niftypsycho/PhobGCCv2-HW_Din/graphics/Din_talking_spring.png

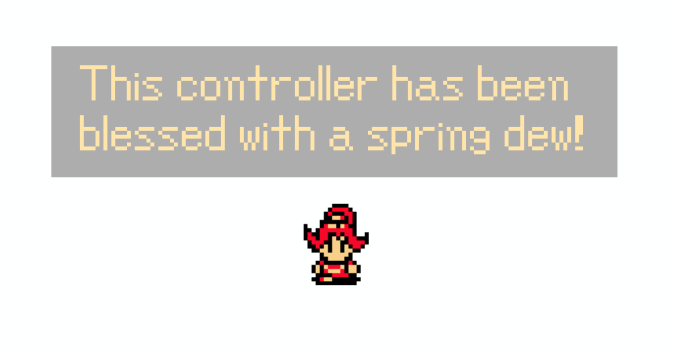
graphics/Din_talking_spring.png
