niftypsycho/PhobGCCv2-HW_Din/3D Models/DH1H1_Magnet_Holder_JLCPCB.STL

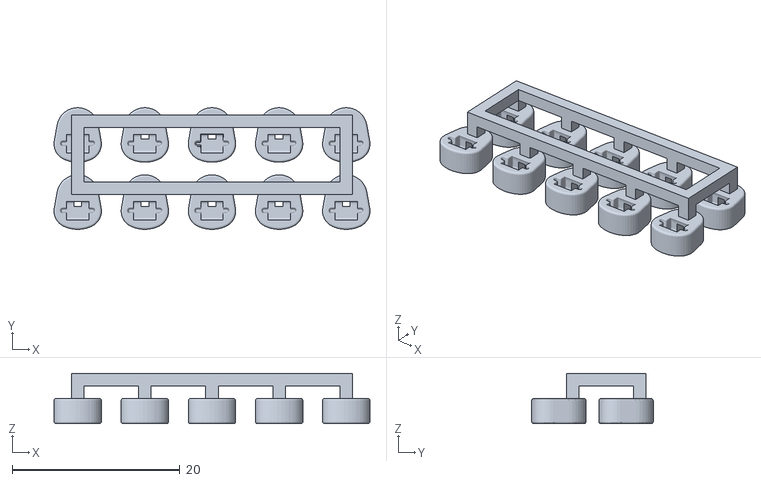
[picture p2: CAD file, 2023-04-25]
3D Models/DH1H1_Magnet_Holder_JLCPCB.STL
37.7 x 14.5 x 6.00
