niftypsycho/PhobGCCv2-HW_Din/(list of files, cad)

Other CAD files:
3D Models/MagnetHolder_underslung_DH1H1.scad
