niftypsycho/PhobGCCv2-HW_Din/PCB/KiCAD/assembly/PhobGCC_2_0_0_proto_1.pdf

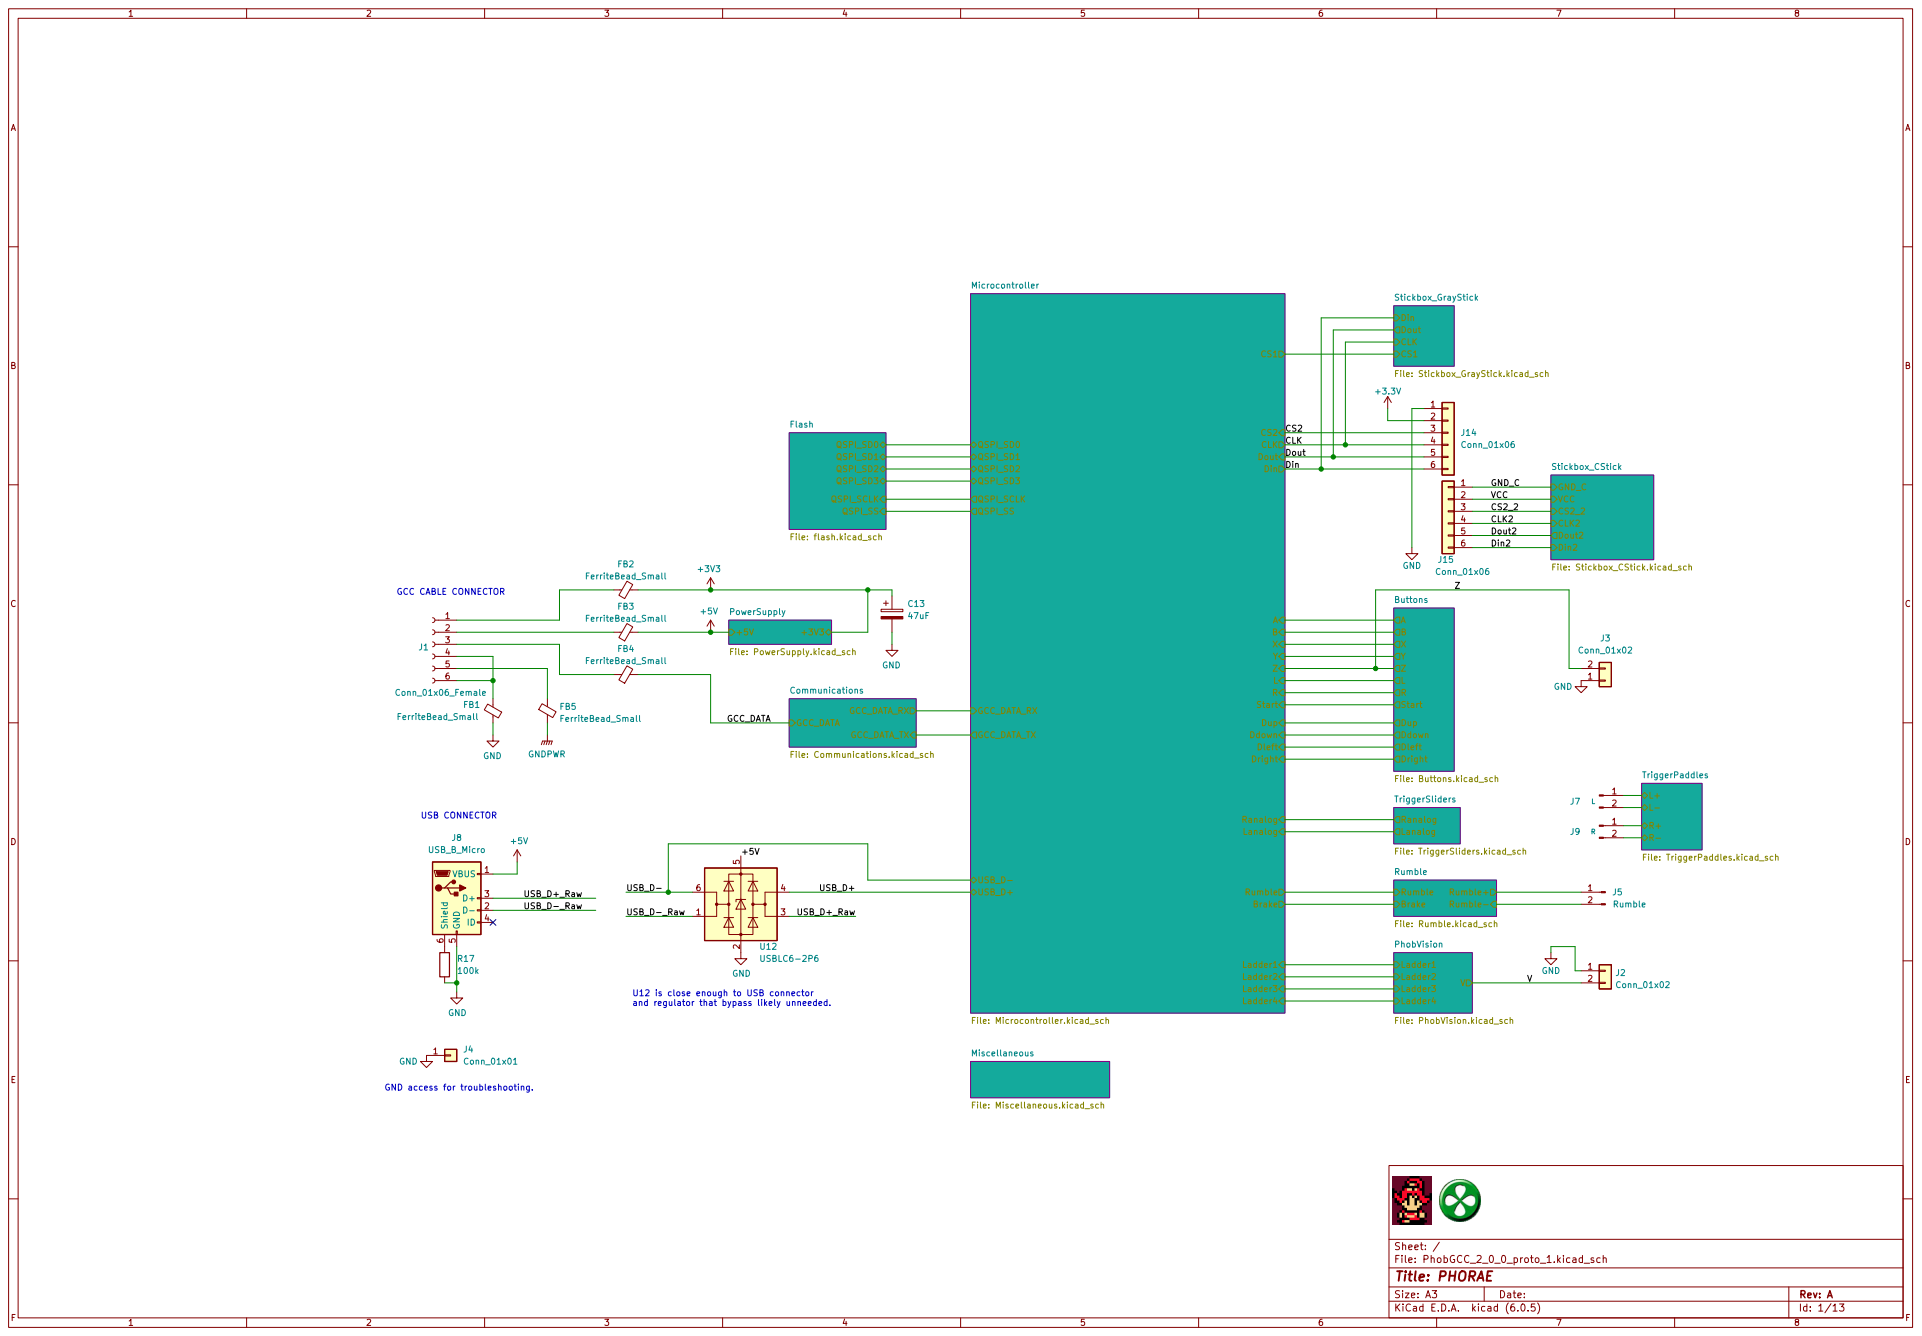
[picture p3: page 1]

Stickbox_CStick File: Stickbox_CStick.kicad_sch Dout CLK CS1 Din Stickbox_GrayStick

CS2_2 U12 is close enough to USB connector

and regulator that bypass likely unneeded. USB CONNECTOR GND access for troubleshooting.

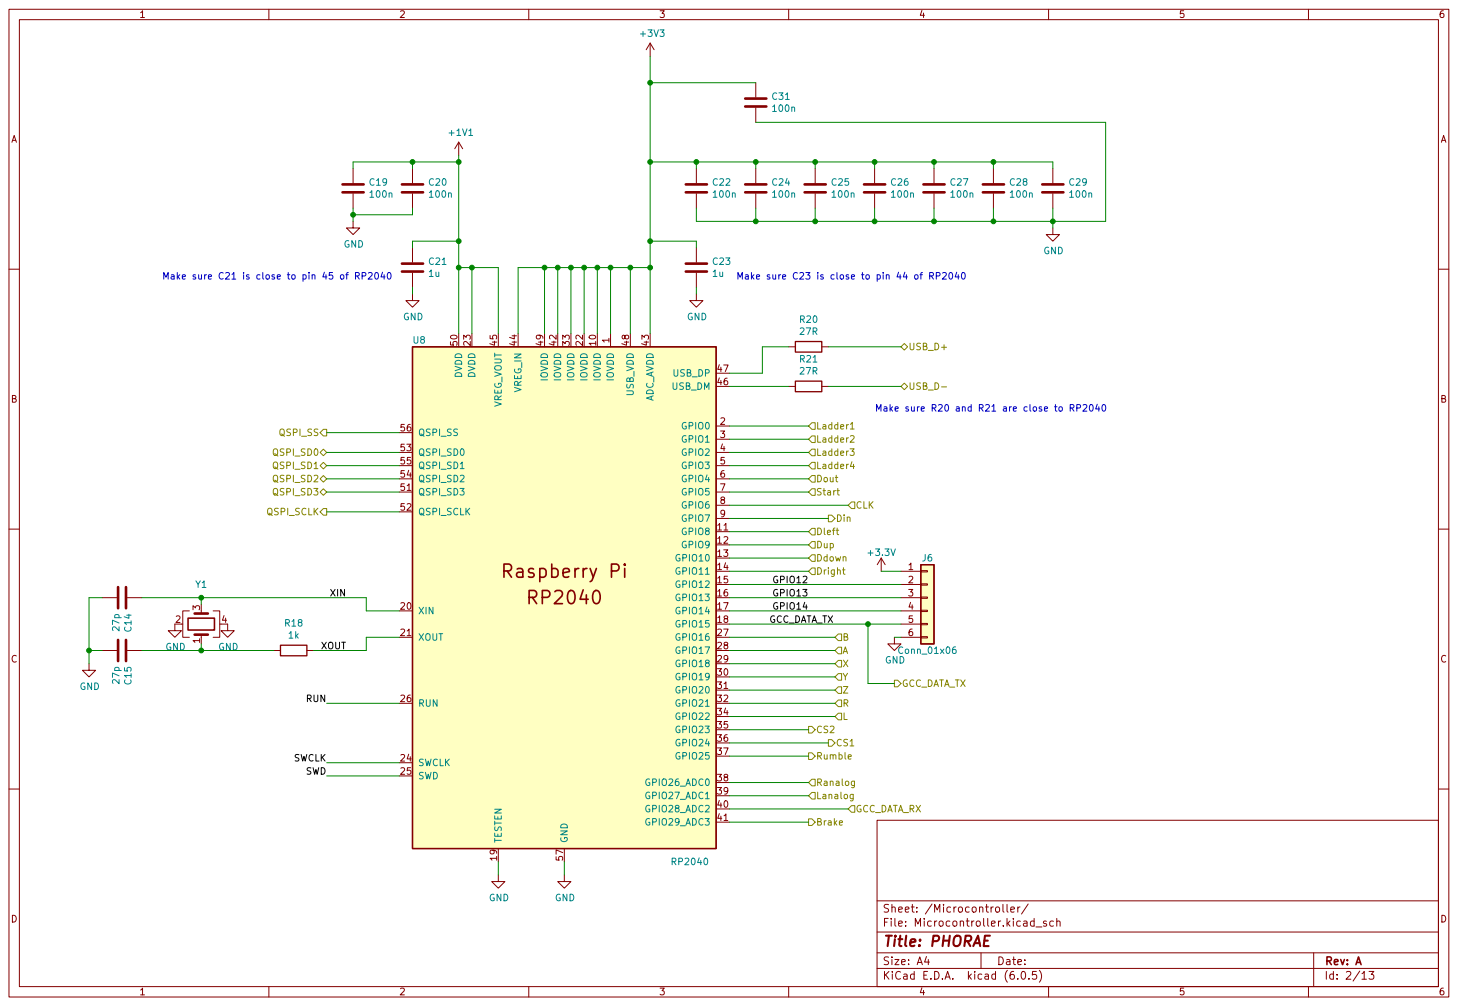
[picture p4: page 2]

1 IOVDD 10 GPIO8 11 GPIO9 12 GPIO10 13 GPIO11 14 GPIO12 15 GPIO13 16 GPIO14 17 GPIO15 18 TESTEN 19 GPIO0 2 XIN 20 XOUT 21 IOVDD 22 DVDD 23 SWCLK 24 SWD 25 RUN 26 GPIO16 27 GPIO17 28 GPIO18 29 GPIO1 3 GPIO19 30 GPIO20 31 GPIO21 32 IOVDD 33 GPIO22 34 GPIO23 35 GPIO24 36 GPIO25 37 GPIO26_ADC0 38 GPIO27_ADC1 39 GPIO2 4 GPIO28_ADC2 40 GPIO29_ADC3 41 IOVDD 42 ADC_AVDD 43 VREG_IN 44 VREG_VOUT 45 USB_DM 46 USB_DP 47 USB_VDD 48 IOVDD 49 GPIO3 5 DVDD 50 QSPI_SD3 51 QSPI_SCLK 52 QSPI_SD0 53 QSPI_SD2 54 QSPI_SD1 55 QSPI_SS 56 GND 57 GPIO4 6 GPIO5 7 GPIO6 8 GPIO7 9 U8 RP2040 StartDin Dright Ddown Dup Dout Ranalog USB_D+

File: Microcontroller.kicad_sch Sheet: /Microcontroller/
Id: 2/13 Title: PHORAE

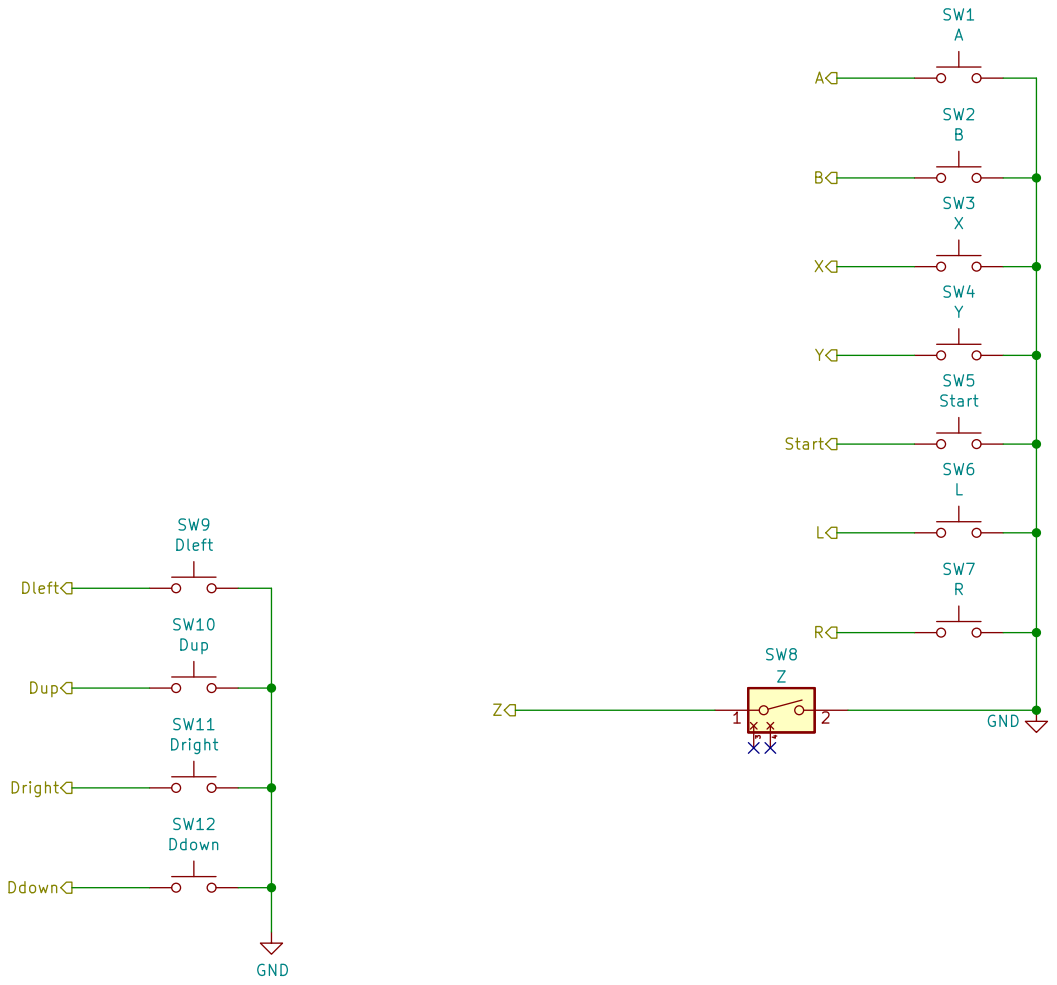
[picture p5: page 3]

File: Buttons.kicad_sch Sheet: /Buttons/
Id: 3/13 Title: PHORAE

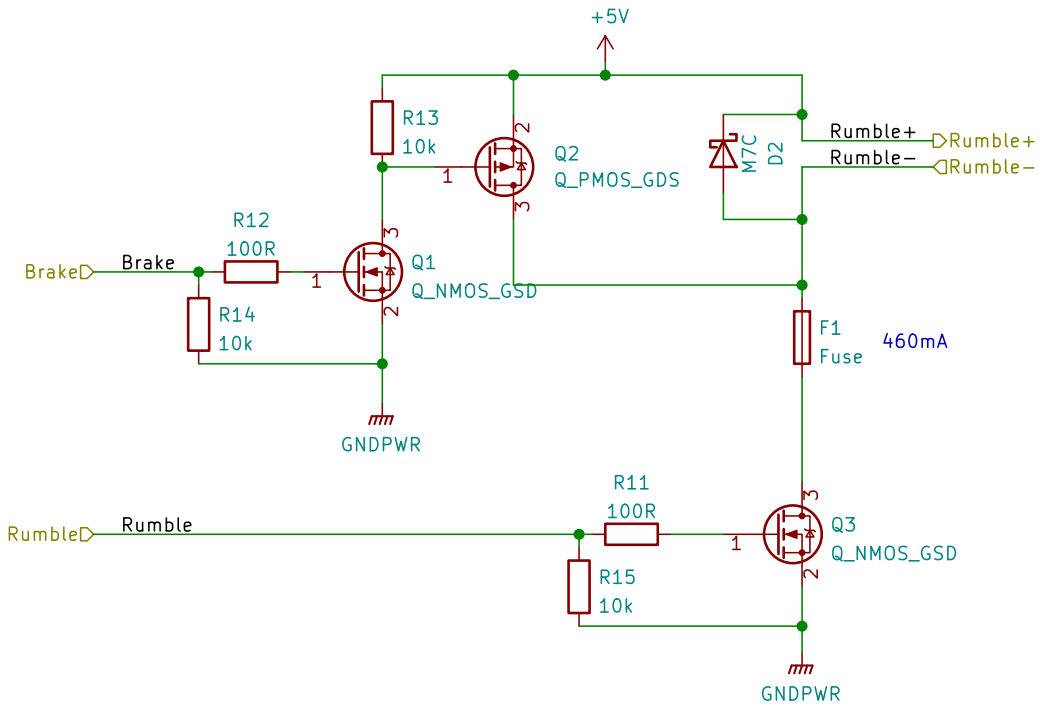
[picture p6: page 4]

File: Rumble.kicad_sch Sheet: /Rumble/ R11

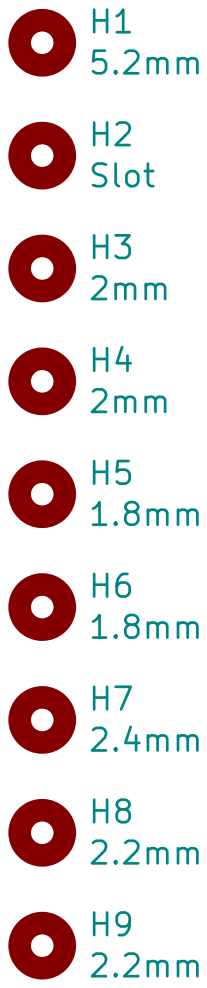
[picture p7: page 5]

File: Miscellaneous.kicad_sch Sheet: /Miscellaneous/
Id: 5/13 Title: PHORAE

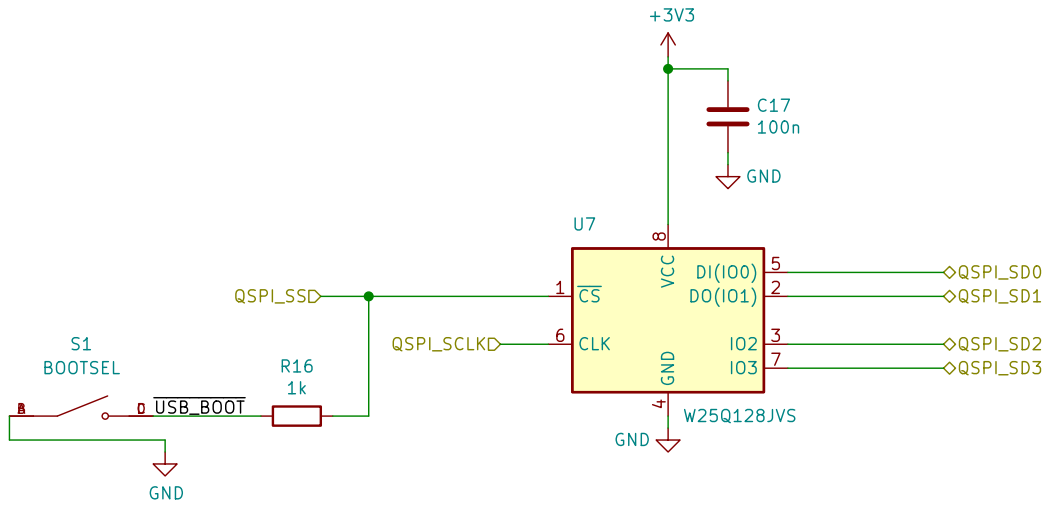
[picture p8: page 6]

File: flash.kicad_sch Sheet: /Flash/
Id: 6/13 Title: PHORAE

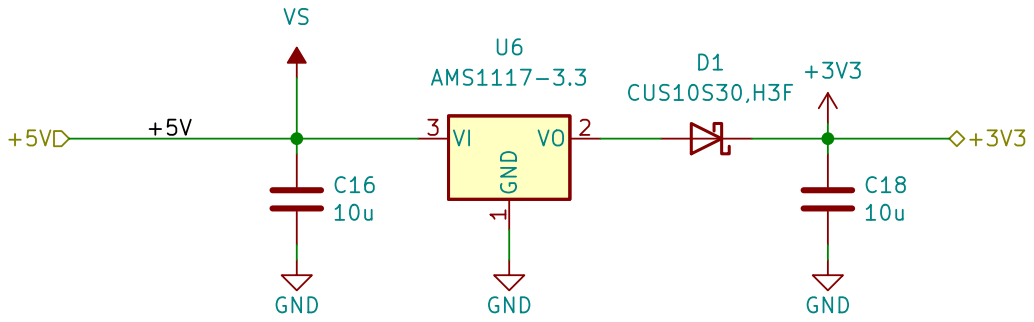
[picture p9: page 7]

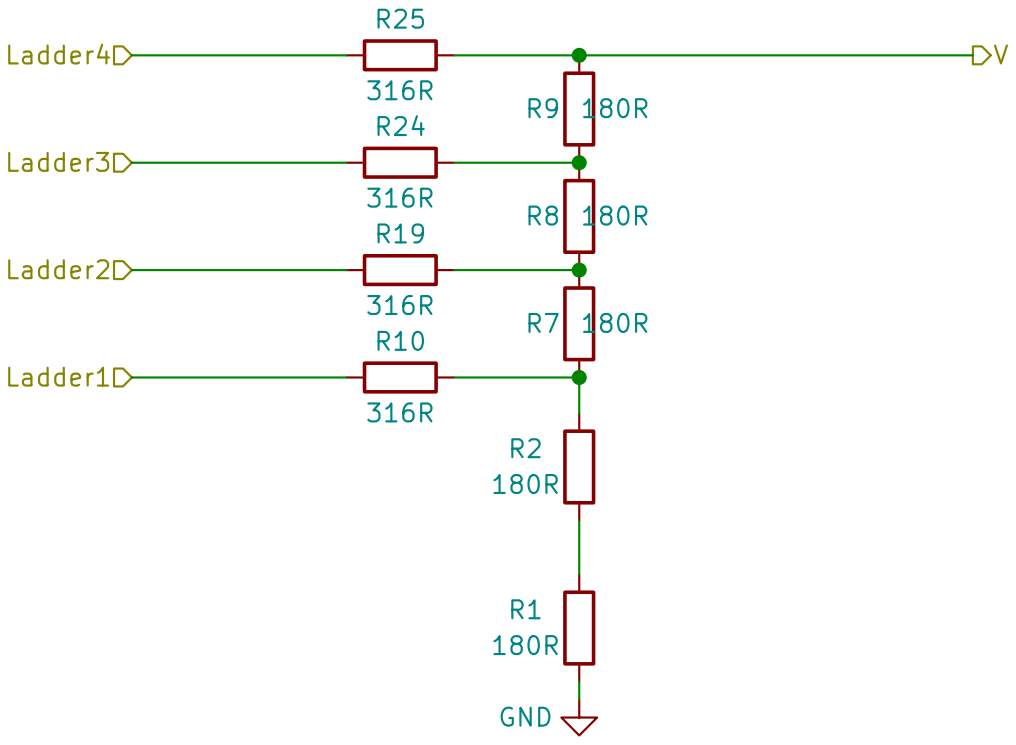
[picture p10: page 8]

File: PhobVision.kicad_sch Sheet: /PhobVision/ GND

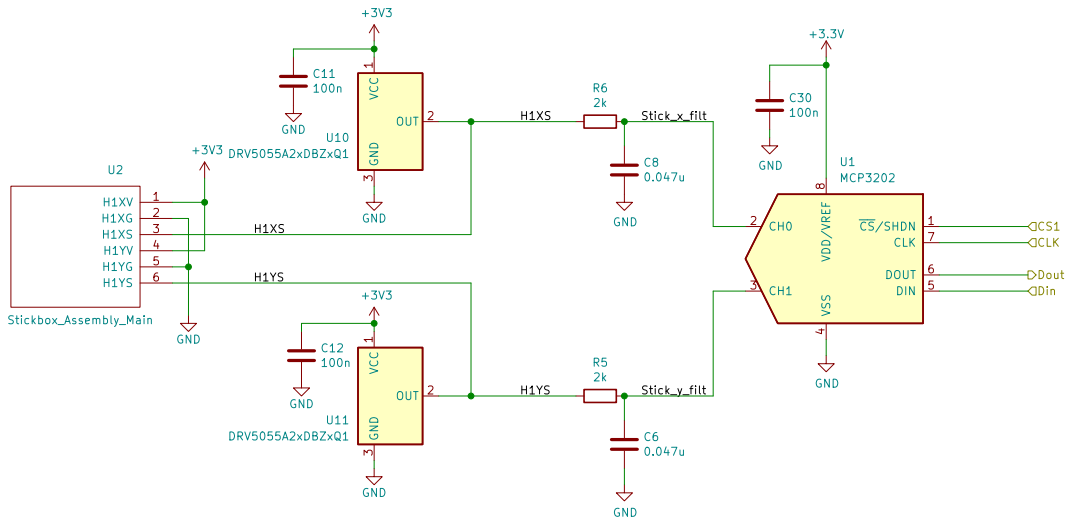
[picture p11: page 9]

4 DIN 5 DOUT 6 CLK 7 VDD/VREF

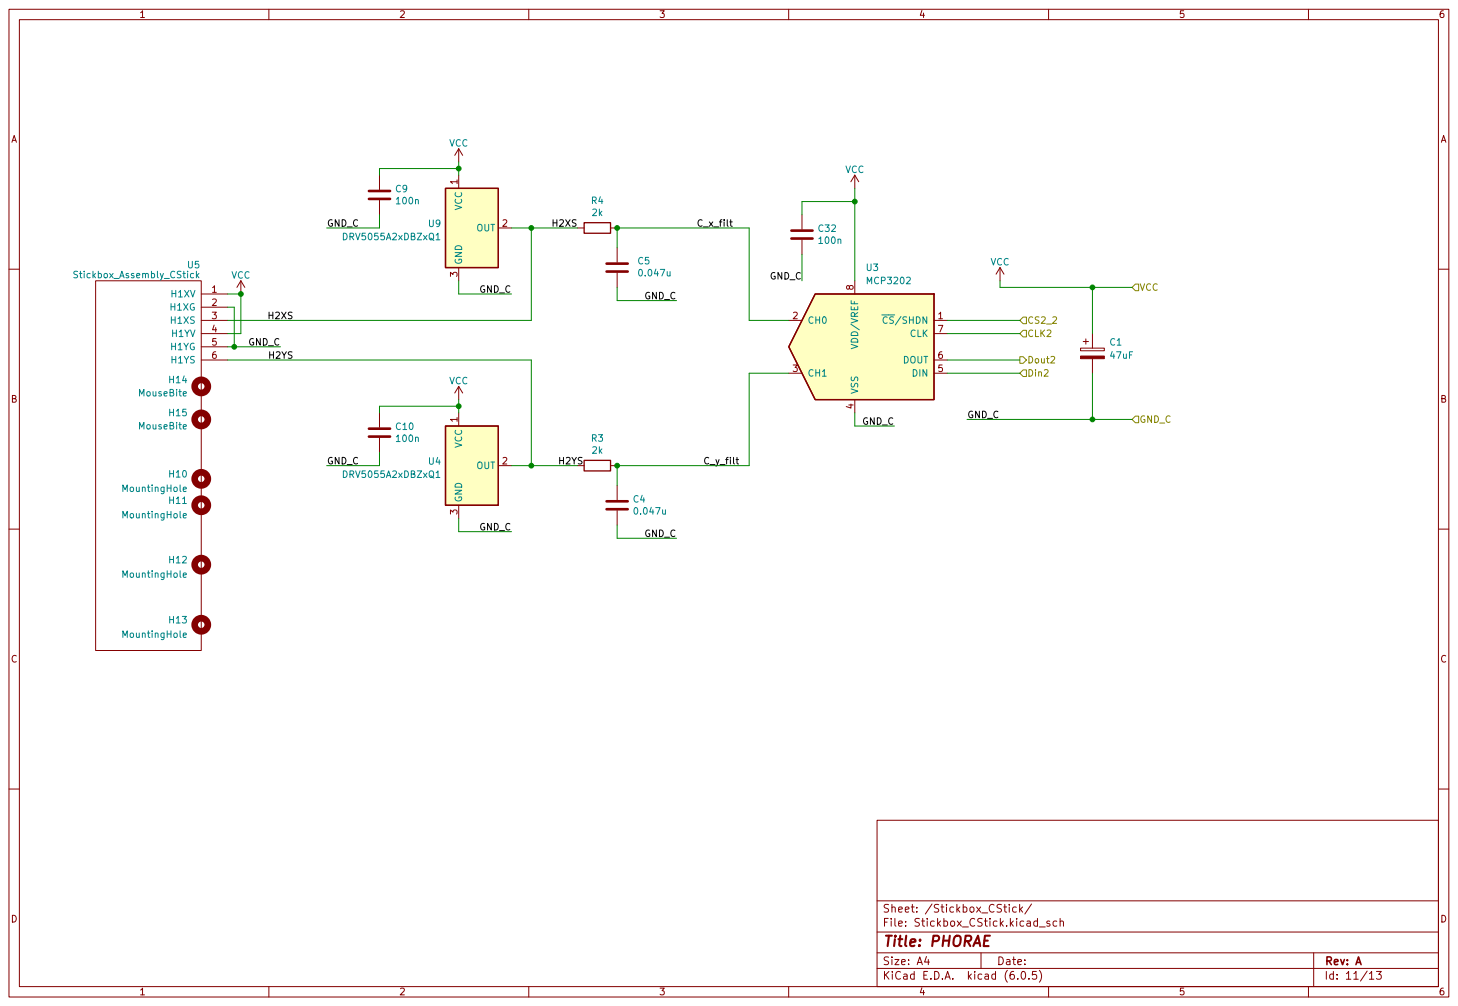
[picture p12: page 10]

4 DIN 5 DOUT 6 CLK 7 VDD/VREF

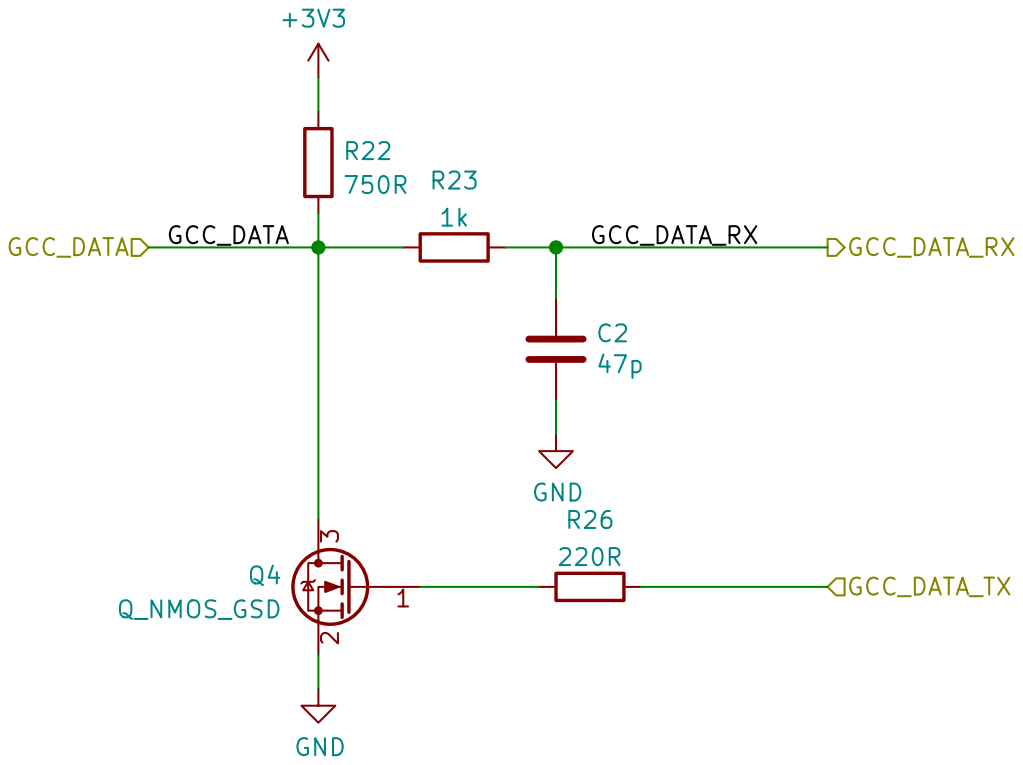
[picture p13: page 11]

File: Communications.kicad_sch Sheet: /Communications/ 1

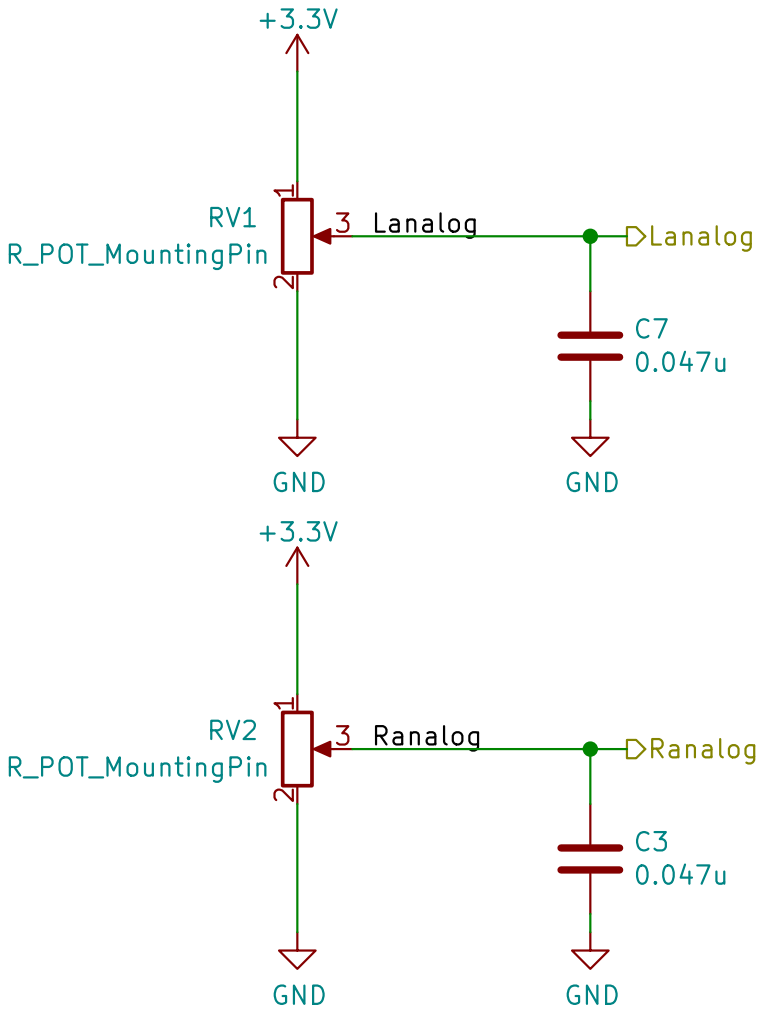
[picture p14: page 12]

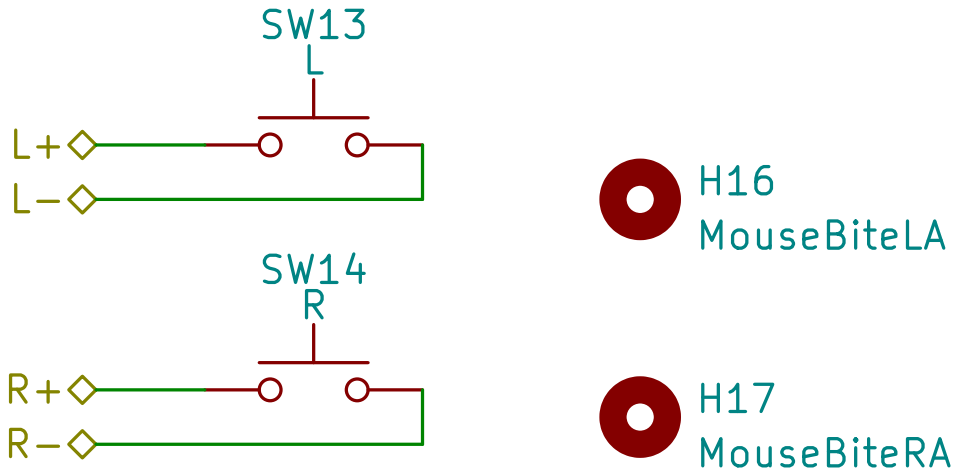
[picture p15: page 13]
