niftypsycho/PhobGCCv2-HW_Din/PCB/KiCAD/Buttons.kicad_sch

## KiCad design PCB/KiCAD/Buttons.kicad_sch (2023-04-25)

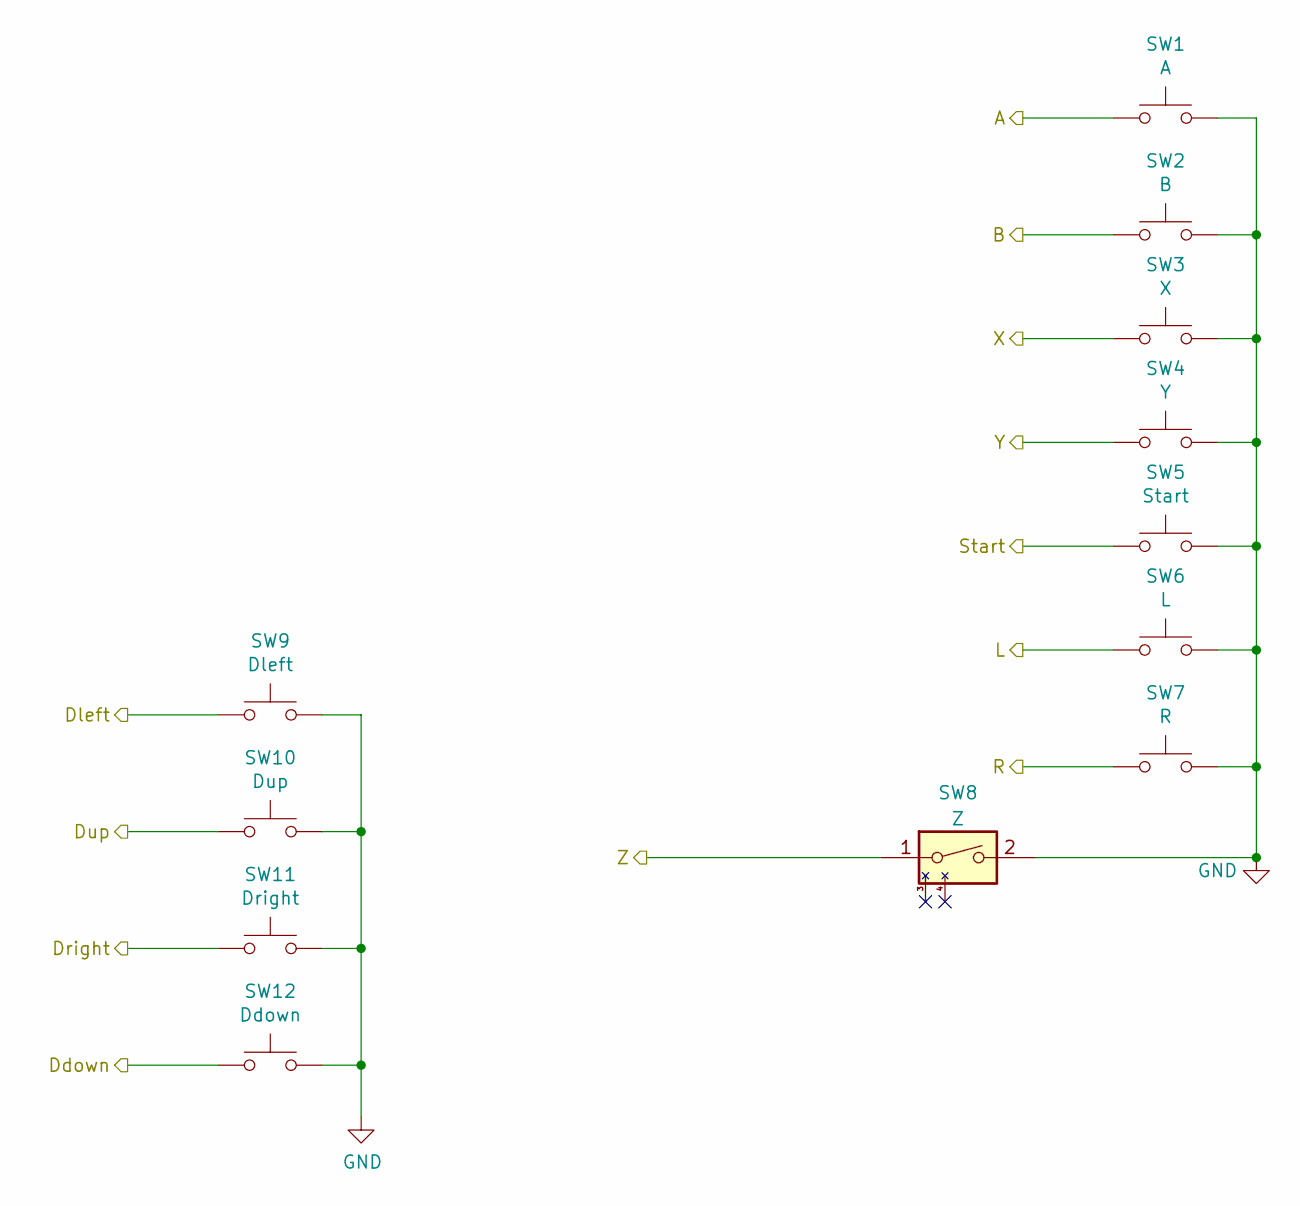
[picture p16: schematic Buttons.kicad_sch]

Parts:
SW1: A; ABXY_Contact_Omron_Switch_Circley
SW2: B; ABXY_Contact_Omron_Switch_Circley
SW3: X; ABXY_Contact_Omron_Switch_Circley
SW4: Y; ABXY_Contact_Omron_Switch_Circley
SW5: Start; Start_Contact
SW6: L; Pin_Header_Straight_1x02_Pitch2.54mm
SW7: R; Pin_Header_Straight_1x02_Pitch2.54mm
SW8: Z; Z_Switch_Edge_Omron; MPN 1825027-5
SW9: Dleft; Dpad_Contact_TL3315NF_2_ZigZag
SW10: Dup; Dpad_Contact_TL3315NF_2_ZigZag
SW11: Dright; Dpad_Contact_TL3315NF_2_ZigZag
SW12: Ddown; Dpad_Contact_TL3315NF_2_ZigZag

Connections:
A: SW1.1
B: SW2.1
Ddown: SW12.1
Dleft: SW9.1
Dright: SW11.1
Dup: SW10.1
GND: SW1.2, SW2.2, SW3.2, SW4.2, SW5.2, SW6.2, SW7.2, SW8.2, SW9.2, SW10.2, SW11.2, SW12.2
L: SW6.1
R: SW7.1
Start: SW5.1
X: SW3.1
Y: SW4.1
Z: SW8.1
