niftypsycho/PhobGCCv2-HW_Din/PCB/KiCAD/Communications.kicad_sch

## KiCad design PCB/KiCAD/Communications.kicad_sch (2023-04-25)

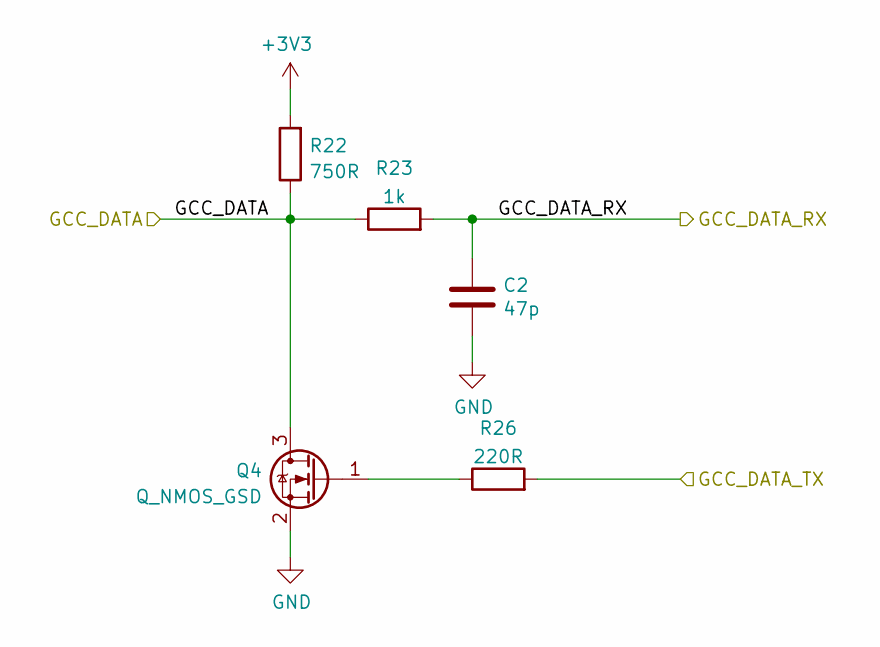
[picture p17: schematic Communications.kicad_sch]

Parts:
C2: 47p; C_0603_1608Metric; MPN CL10C470JB81PNC
Q4: Q_NMOS_GSD; SOT-23; MPN T2N7002AK,LM
R22: 750R; R_0603_1608Metric; MPN RC0603JR-07750RL
R23: 1k; R_0603_1608Metric; MPN RNCP0603FTD1K00
R26: 220R; R_0603_1608Metric; MPN RMCF0603JT220R

Connections:
+3V3: R22.2
GCC_DATA: Q4.3 (D), R22.1, R23.1
GCC_DATA_RX: C2.1, R23.2
GCC_DATA_TX: R26.2
GND: C2.2, Q4.2 (S)
unnamed: Q4.1 (G), R26.1
