niftypsycho/PhobGCCv2-HW_Din/PCB/KiCAD/Microcontroller.kicad_sch

## KiCad design PCB/KiCAD/Microcontroller.kicad_sch (2023-04-25)

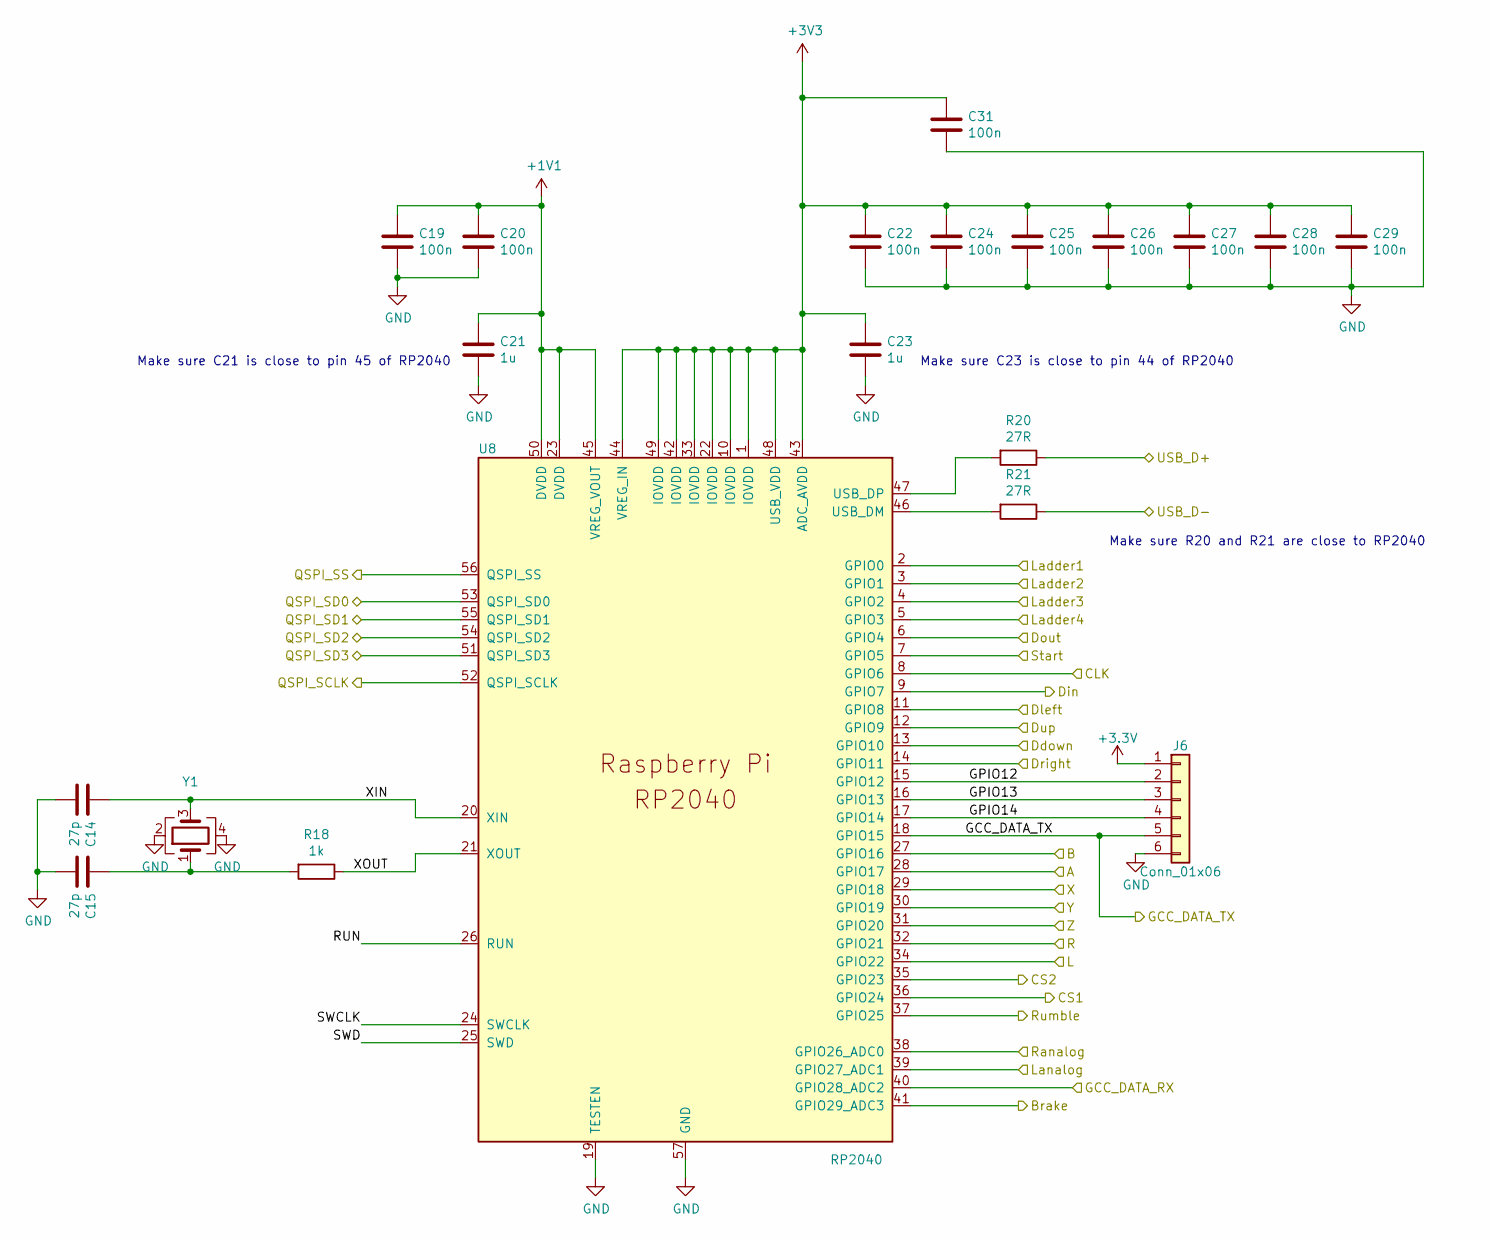
[picture p18: schematic Microcontroller.kicad_sch]

Parts:
C14, C15: 27p; C_0402_1005Metric; MPN 0402YA270JAT2A
C19, C20, C22, C24, C25, C26, C27, C28, C29, C31: 100n; C_0402_1005Metric; MPN CL05B104KA5NNNC
C21, C23: 1u; C_0402_1005Metric; MPN GRM155Z71A105KE01J
J6: Conn_01x06; PinSocket_1x06_P2.00mm_Vertical
R18: 1k; C_0402_1005Metric; MPN RMCF0402FT1K00
R20, R21: 27R; C_0402_1005Metric; MPN RC0402FR-0727RL
U8: RP2040; RP2040-QFN-56; MPN SC0914(13)
Y1: Crystal_GND24; Crystal_SMD_3225-4Pin_3.2x2.5mm; MPN RH100-12.000-18-2020-EXT-TR; LCSC C403945

Connections:
+1V1: C19.1, C20.1, C21.1, U8.23 (DVDD), U8.45 (VREG_VOUT), U8.50 (DVDD)
+3.3V: J6.1
+3V3: C22.1, C23.1, C24.1, C25.1, C26.1, C27.1, C28.1, C29.1, C31.1, U8.1 (IOVDD), U8.10 (IOVDD), U8.22 (IOVDD), U8.33 (IOVDD), U8.42 (IOVDD), U8.43 (ADC_AVDD), U8.44 (VREG_IN), U8.48 (USB_VDD), U8.49 (IOVDD)
A: U8.28 (GPIO17)
B: U8.27 (GPIO16)
Brake: U8.41 (GPIO29_ADC3)
CLK: U8.8 (GPIO6)
CS1: U8.36 (GPIO24)
CS2: U8.35 (GPIO23)
Ddown: U8.13 (GPIO10)
Din: U8.9 (GPIO7)
Dleft: U8.11 (GPIO8)
Dout: U8.6 (GPIO4)
Dright: U8.14 (GPIO11)
Dup: U8.12 (GPIO9)
GCC_DATA_RX: U8.40 (GPIO28_ADC2)
GCC_DATA_TX: J6.5, U8.18 (GPIO15)
GND: C14.2, C15.2, C19.2, C20.2, C21.2, C22.2, C23.2, C24.2, C25.2, C26.2, C27.2, C28.2, C29.2, C31.2, J6.6, U8.19 (TESTEN), U8.57 (GND), Y1.2, Y1.4
GPIO12: J6.2, U8.15 (GPIO12)
GPIO13: J6.3, U8.16 (GPIO13)
GPIO14: J6.4, U8.17 (GPIO14)
L: U8.34 (GPIO22)
Ladder1: U8.2 (GPIO0)
Ladder2: U8.3 (GPIO1)
Ladder3: U8.4 (GPIO2)
Ladder4: U8.5 (GPIO3)
Lanalog: U8.39 (GPIO27_ADC1)
unnamed: C15.1, R18.2, Y1.1
unnamed: R20.2, U8.47 (USB_DP)
unnamed: R21.2, U8.46 (USB_DM)
QSPI_SCLK: U8.52 (QSPI_SCLK)
QSPI_SD0: U8.53 (QSPI_SD0)
QSPI_SD1: U8.55 (QSPI_SD1)
QSPI_SD2: U8.54 (QSPI_SD2)
QSPI_SD3: U8.51 (QSPI_SD3)
QSPI_SS: U8.56 (QSPI_SS)
R: U8.32 (GPIO21)
RUN: U8.26 (RUN)
Ranalog: U8.38 (GPIO26_ADC0)
Rumble: U8.37 (GPIO25)
SWCLK: U8.24 (SWCLK)
SWD: U8.25 (SWD)
Start: U8.7 (GPIO5)
USB_D+: R20.1
USB_D-: R21.1
X: U8.29 (GPIO18)
XIN: C14.1, U8.20 (XIN), Y1.3
XOUT: R18.1, U8.21 (XOUT)
Y: U8.30 (GPIO19)
Z: U8.31 (GPIO20)

Notes on the sheet:
Make sure C21 is close to pin 45 of RP2040
Make sure C23 is close to pin 44 of RP2040
Make sure R20 and R21 are close to RP2040
