niftypsycho/PhobGCCv2-HW_Din/PCB/KiCAD/Miscellaneous.kicad_sch

## KiCad design PCB/KiCAD/Miscellaneous.kicad_sch (2023-04-25)

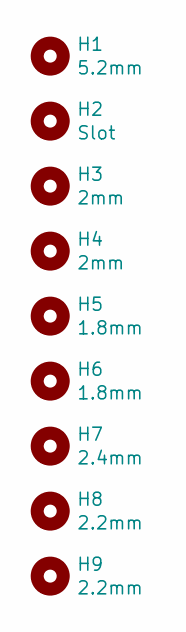
[picture p19: schematic Miscellaneous.kicad_sch]

Parts:
H1: 5.2mm; MountingHole_5.2mm
H2: Slot
H3, H4: 2mm; MountingHole_2.0mm
H5, H6: 1.8mm; MountingHole_1.8mm
H7: 2.4mm; MountingHole_2.4mm
H8, H9: 2.2mm; MountingHole_2.2mm
