niftypsycho/PhobGCCv2-HW_Din/PCB/KiCAD/PhobGCC_2_0_0_proto_1.kicad_sch

## KiCad design PCB/KiCAD/PhobGCC_2_0_0_proto_1.kicad_sch (2023-04-25)

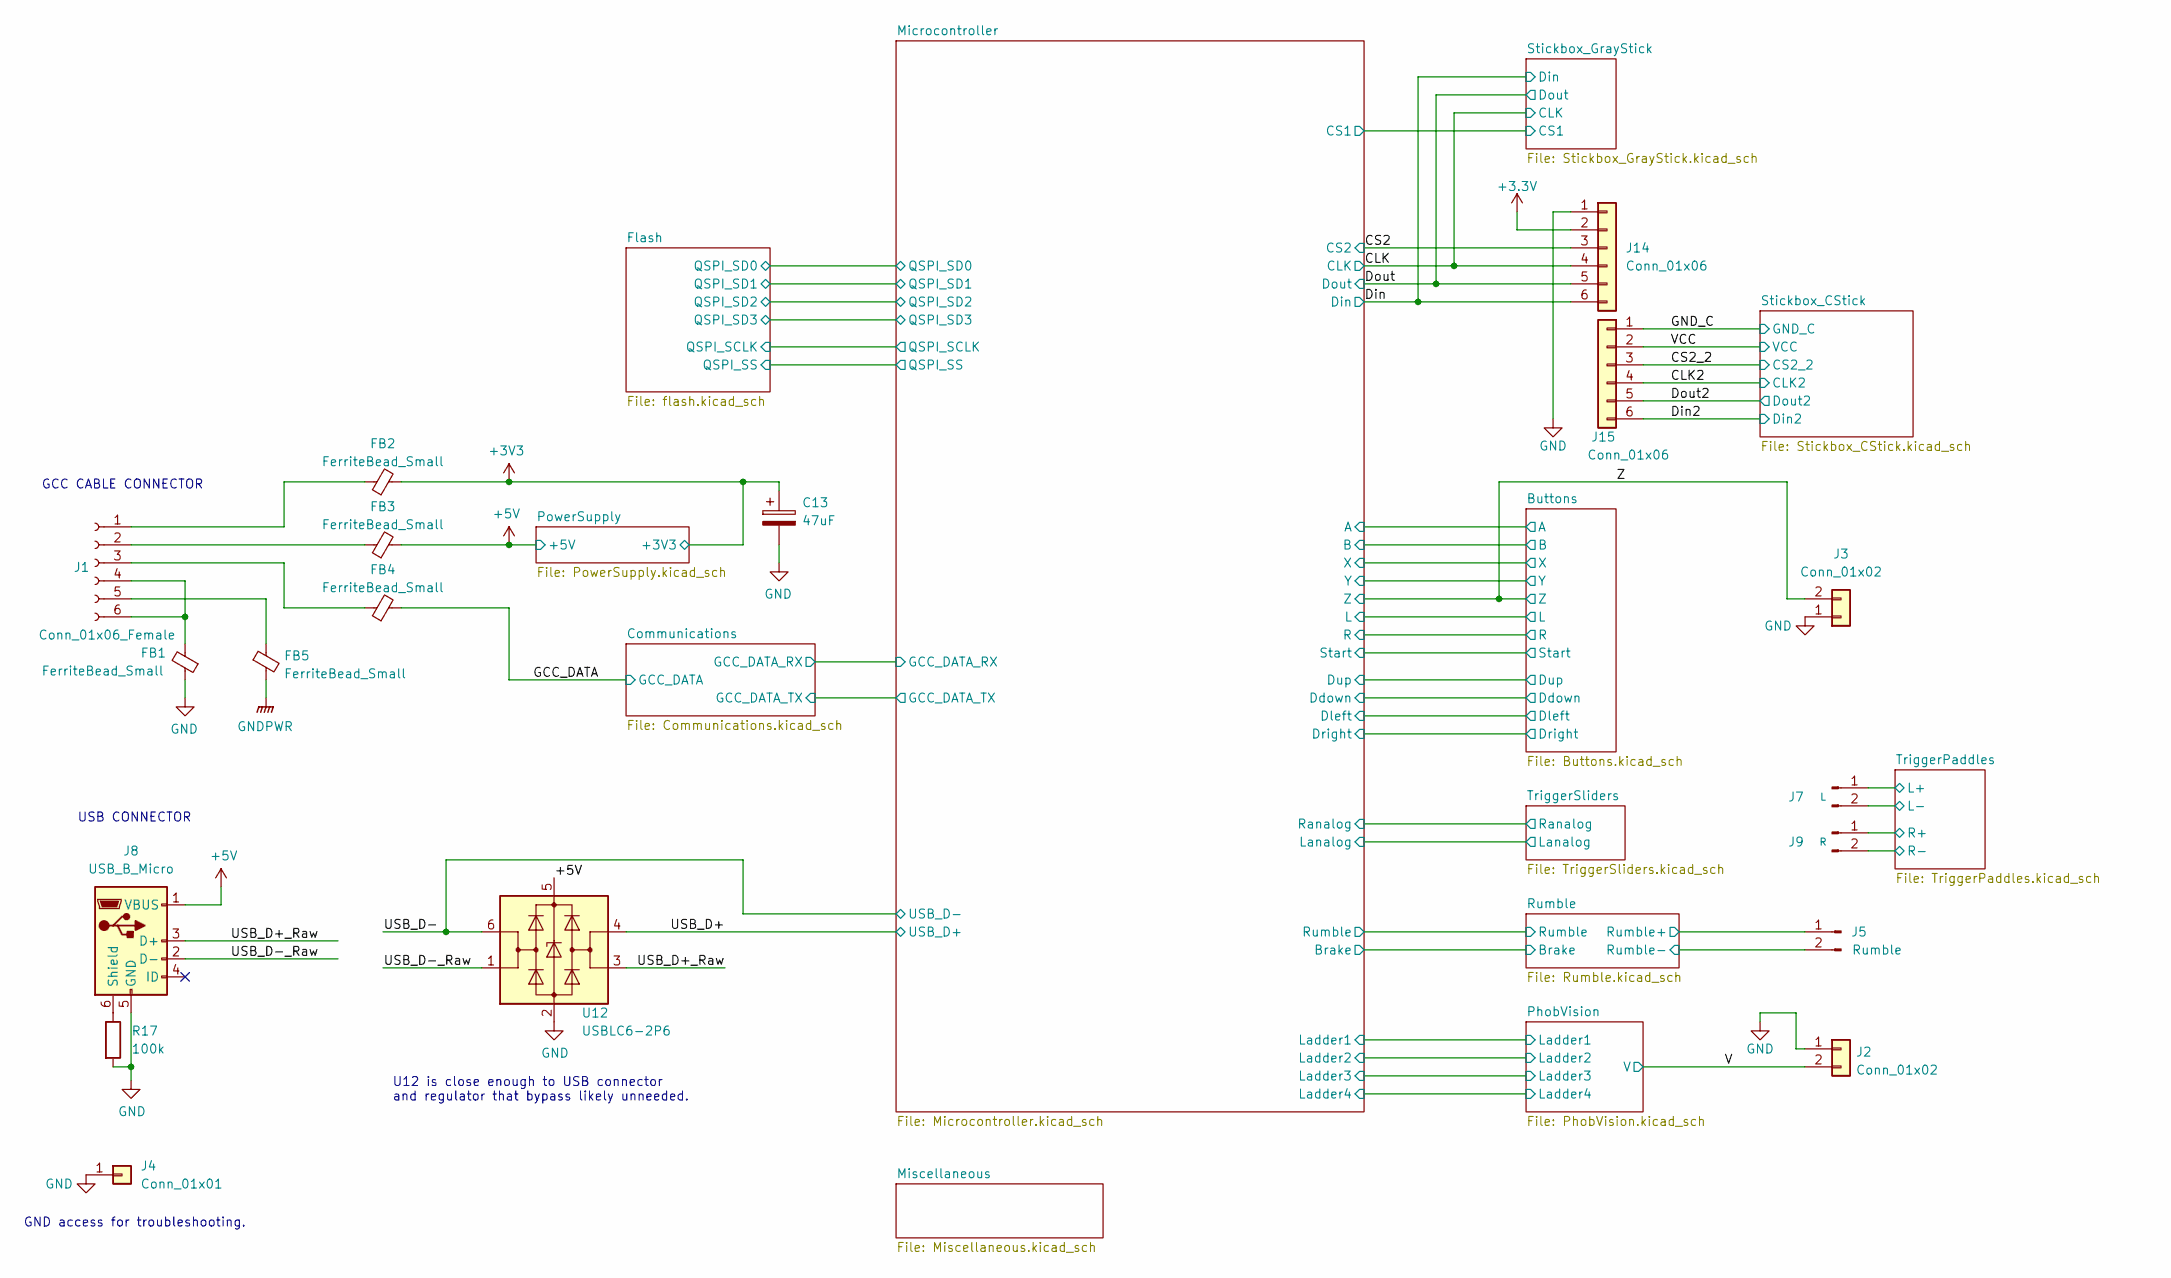
[picture p20: schematic PhobGCC_2_0_0_proto_1.kicad_sch]

Parts:
C13: 47uF; CP_EIA-3528-12_Kemet-T_Pad1.50x2.35mm_HandSolder; MPN GRM32ER71A476ME15L
FB1, FB2, FB3, FB5: FerriteBead_Small; R_0805_2012Metric; MPN 2508056017Y2
FB4: FerriteBead_Small; R_0603_1608Metric; MPN MMZ1608B601CTAH0
J1: Conn_01x06_Female; GCC_Header_Straight_1x06_Pitch2.00mm
J2: Conn_01x02; PinHeader_1x02_P2.00mm_Vertical
J3: Conn_01x02; PinHeader_1x02_P2.00mm_Horizontal
J4: Conn_01x01; PinHeader_1x01_P2.54mm_Vertical
J5: Rumble; rumble_pins
J7: L; Pin_Header_Straight_1x02_Pitch2.54mm
J8: USB_B_Micro; USB_Micro-B_Amphenol_10118194_Horizontal; MPN 10118194-0001LF
J9: R; Pin_Header_Straight_1x02_Pitch2.54mm
J14, J15: Conn_01x06; PinSocket_1x06_P2.00mm_Vertical
R17: 100k; R_0603_1608Metric_Pad0.98x0.95mm_HandSolder; MPN RC0603FR-07100KL
U12: USBLC6-2P6; SOT-666; MPN USBLC6-2P6

Connections:
+3.3V: J14.2
+3V3: C13.1, FB2.2
+5V: FB3.2, J8.1 (VBUS), U12.5 (VBUS)
CLK: J14.4
CLK2: J15.4
CS2: J14.3
CS2_2: J15.3
Din: J14.6
Din2: J15.6
Dout: J14.5
Dout2: J15.5
GCC_DATA: FB4.2
GND: C13.2, FB1.1, J2.1, J3.1, J4.1, J8.5 (GND), J14.1, R17.2, U12.2 (GND)
GNDPWR: FB5.2
GND_C: J15.1
L+: J7.1
L-: J7.2
unnamed: FB1.2, J1.4, J1.6
unnamed: FB2.1, J1.1
unnamed: FB3.1, J1.2
unnamed: FB4.1, J1.3
unnamed: FB5.1, J1.5
unnamed: J8.6 (Shield), R17.1
R+: J9.1
R-: J9.2
Rumble+: J5.1
Rumble-: J5.2
USB_D+: U12.4 (I/O2)
USB_D+_Raw: J8.3 (D+), U12.3 (I/O2)
USB_D-: U12.6 (I/O1)
USB_D-_Raw: J8.2 (D-), U12.1 (I/O1)
V: J2.2
VCC: J15.2
Z: J3.2

Notes on the sheet:
GND access for troubleshooting.
GCC CABLE CONNECTOR
USB CONNECTOR
U12 is close enough to USB connector and regulator that bypass likely unneeded.
