niftypsycho/PhobGCCv2-HW_Din/PCB/KiCAD/PhobVision.kicad_sch

## KiCad design PCB/KiCAD/PhobVision.kicad_sch (2023-04-25)

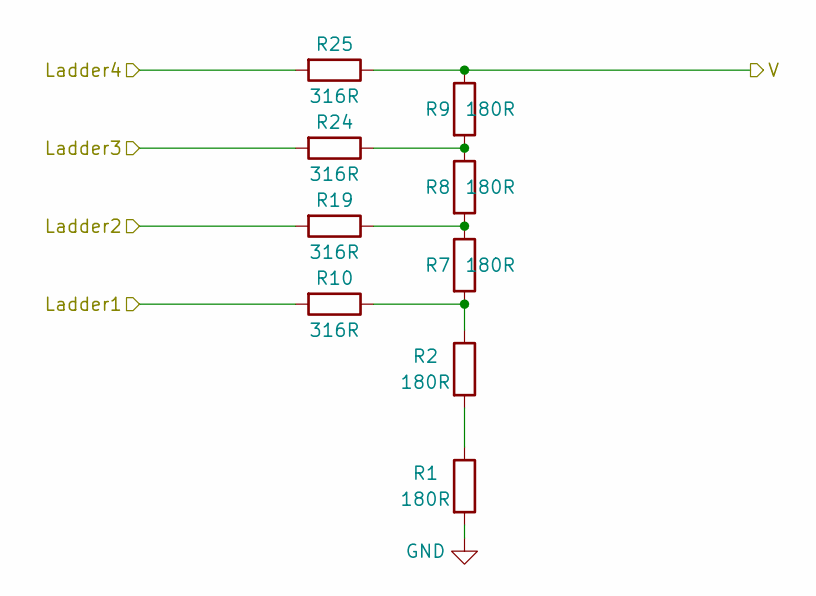
[picture p21: schematic PhobVision.kicad_sch]

Parts:
R1, R2, R7, R8, R9: 180R; R_0402_1005Metric; MPN RC0402FR-07180RL
R10, R19, R24, R25: 316R; R_0402_1005Metric; MPN RC0402FR-07316RL

Connections:
GND: R1.2
Ladder1: R10.2
Ladder2: R19.2
Ladder3: R24.2
Ladder4: R25.2
unnamed: R1.1, R2.2
unnamed: R2.1, R7.2, R10.1
unnamed: R7.1, R8.2, R19.1
unnamed: R8.1, R9.2, R24.1
V: R9.1, R25.1
