niftypsycho/PhobGCCv2-HW_Din/PCB/KiCAD/PowerSupply.kicad_sch

## KiCad design PCB/KiCAD/PowerSupply.kicad_sch (2023-04-25)

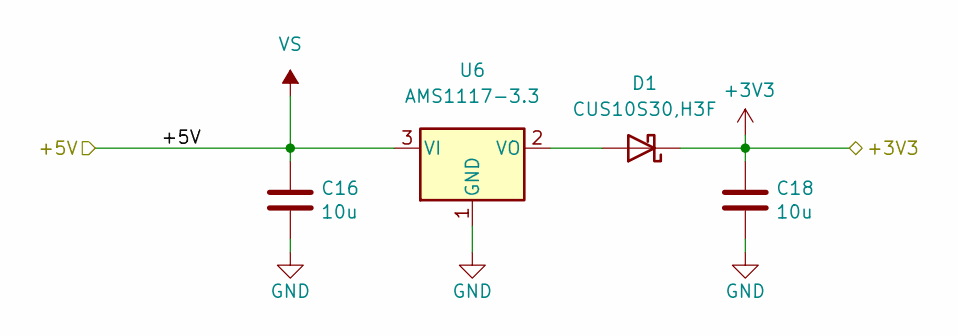
[picture p22: schematic PowerSupply.kicad_sch]

Parts:
C16, C18: 10u; C_0805_2012Metric; MPN GRM21BR71A106KA73K
D1: CUS10S30,H3F; D_SOD-323; MPN CUS10S30,H3F
U6: AMS1117-3.3; SOT-223-3_TabPin2; MPN AMS1117-3.3

Connections:
+3V3: C18.1, D1.1 (K)
GND: C16.2, C18.2, U6.1 (GND)
unnamed: D1.2 (A), U6.2 (VO)
VS: C16.1, U6.3 (VI)
