niftypsycho/PhobGCCv2-HW_Din/PCB/KiCAD/Rumble.kicad_sch

## KiCad design PCB/KiCAD/Rumble.kicad_sch (2023-04-25)

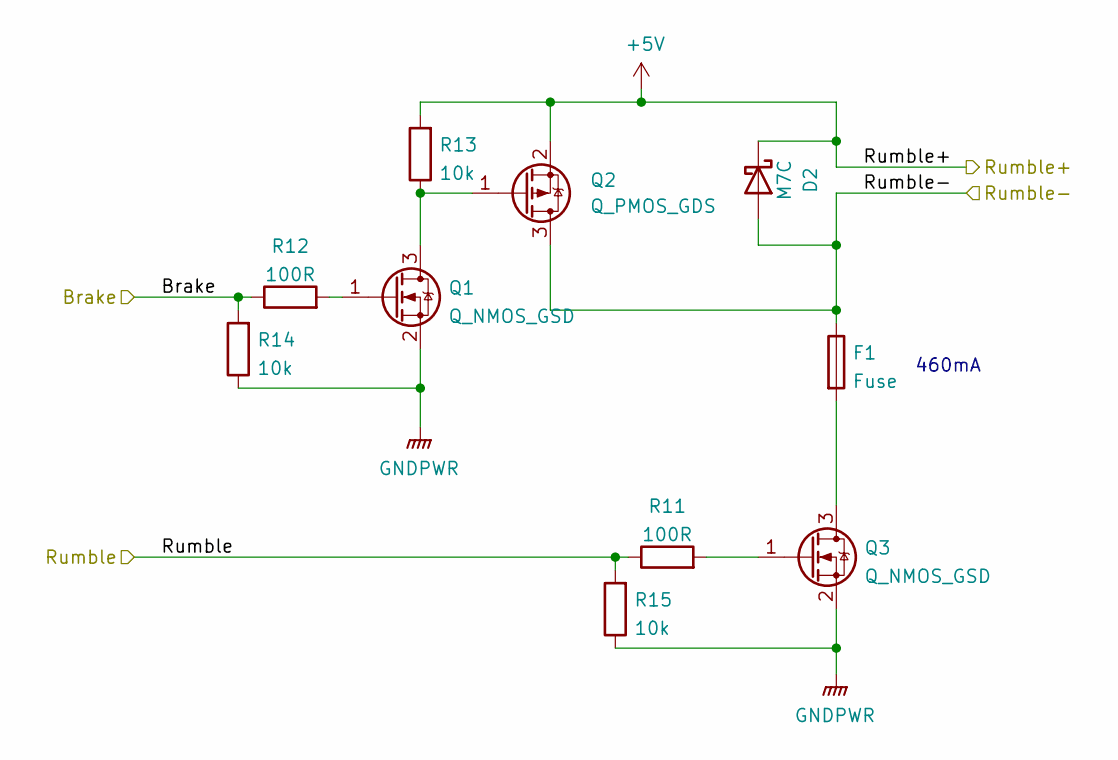
[picture p23: schematic Rumble.kicad_sch]

Parts:
D2: M7C; D_SOD-123; MPN B5819W; LCSC C8598
F1: Fuse; Fuse_1206_3216Metric; MPN PTS120624V020; LCSC C69680
Q1, Q3: Q_NMOS_GSD; SOT-23; MPN AO3400A; LCSC C20917
Q2: Q_PMOS_GDS; SOT-23; MPN AO3401A; LCSC C15127
R11, R12: 100R; R_0603_1608Metric_Pad0.98x0.95mm_HandSolder; MPN RMCF0603FT100R; LCSC C22775
R13, R14, R15: 10k; R_0603_1608Metric_Pad0.98x0.95mm_HandSolder; MPN RNCP0603FTD10K0; LCSC C25804

Connections:
+5V: D2.1 (K), Q2.2 (S), R13.2
Brake: R12.1, R14.2
GNDPWR: Q1.2 (S), Q3.2 (S), R14.1, R15.1
unnamed: F1.2, Q3.3 (D)
unnamed: Q1.1 (G), R12.2
unnamed: Q1.3 (D), Q2.1 (G), R13.1
unnamed: Q3.1 (G), R11.2
Rumble: R11.1, R15.2
Rumble-: D2.2 (A), F1.1, Q2.3 (D)

Notes on the sheet:
460mA
