niftypsycho/PhobGCCv2-HW_Din/PCB/KiCAD/Stickbox_CStick.kicad_sch

## KiCad design PCB/KiCAD/Stickbox_CStick.kicad_sch (2023-04-25)

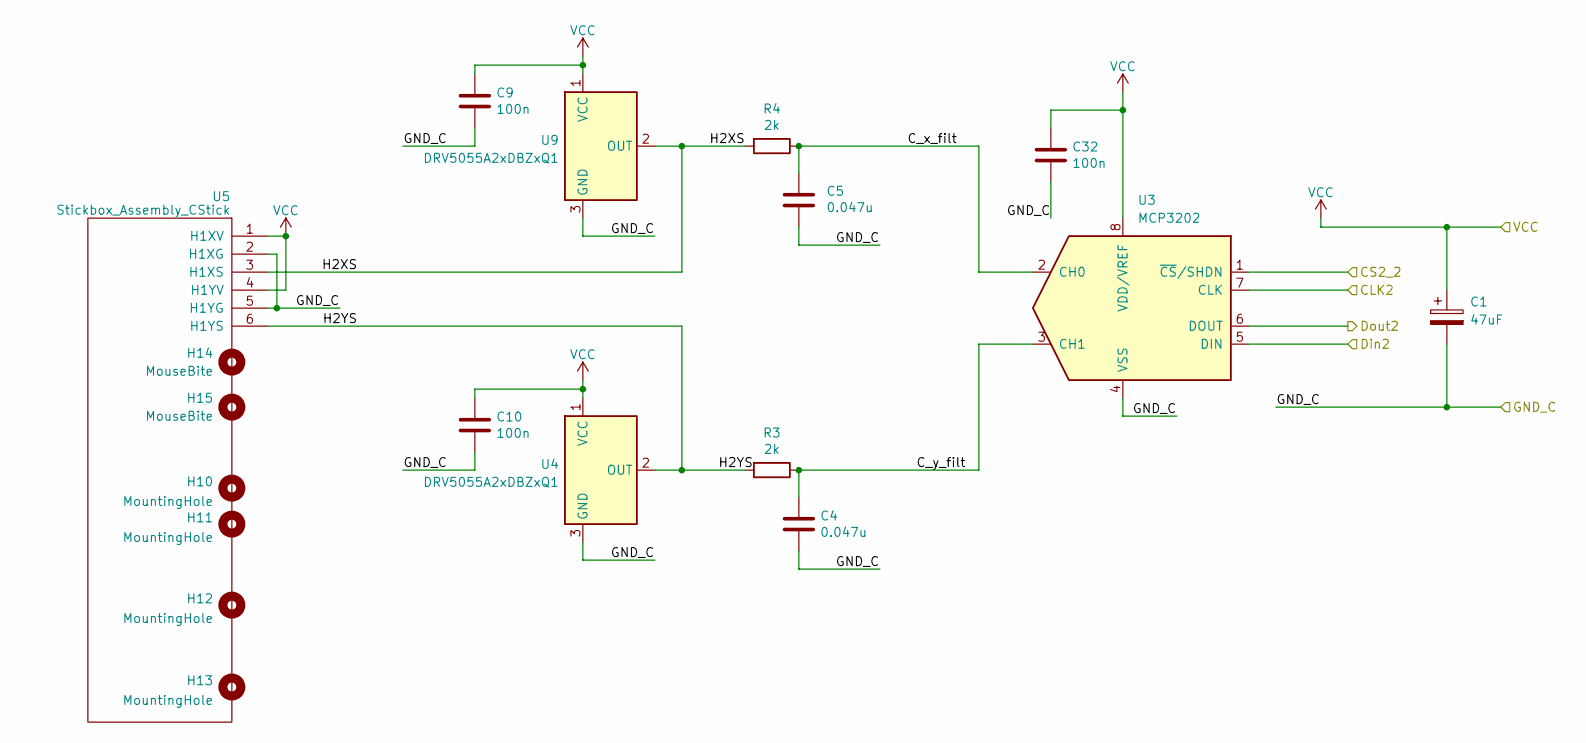
[picture p24: schematic Stickbox_CStick.kicad_sch]

Parts:
C1: 47uF; CP_EIA-3528-12_Kemet-T_Pad1.50x2.35mm_HandSolder; MPN GRM32ER71A476ME15L
C4, C5: 0.047u; C_0603_HandSoldering; MPN CL10B473KB8NNNC; LCSC C1622
C9, C10: 100n; C_0603_1608Metric; MPN CL10B104KB8NNWC
C32: 100n; C_0402_1005Metric; MPN CL05B104KA5NNNC
H10: MountingHole; MountingHole_1.8mm
H11: MountingHole; MountingHole_5.2mm
H12, H13: MountingHole; MountingHole_2.0mm
H14: MouseBite; breakaway-mousebites-double-v2-small
H15: MouseBite; breakaway-mousebites-double-v2-large
R3, R4: 2k; R_0603_1608Metric_Pad0.98x0.95mm_HandSolder; MPN RC0603FR-132KL; LCSC C22975
U3: MCP3202; SOIC-8_3.9x4.9mm_P1.27mm; MPN MCP3202-CI/SN
U4, U9: DRV5055A2xDBZxQ1; SOT-23; MPN DRV5055A3QDBZR; LCSC C266128
U5: Stickbox_Assembly_CStick; GCC_Stickbox_Hall_Only; MPN T3+Magnet_Assy

Connections:
CLK2: U3.7 (CLK)
CS2_2: U3.1 (~CS/SHDN)
C_x_filt: C5.1, R4.1, U3.2 (CH0)
C_y_filt: C4.1, R3.1, U3.3 (CH1)
Din2: U3.5 (DIN)
Dout2: U3.6 (DOUT)
GND_C: C1.2, C4.2, C5.2, C9.2, C10.2, C32.2, U3.4 (VSS), U4.3 (GND), U5.2 (H1XG), U5.5 (H1YG), U9.3 (GND)
H2XS: R4.2, U5.3 (H1XS), U9.2 (OUT)
H2YS: R3.2, U4.2 (OUT), U5.6 (H1YS)
VCC: C1.1, C9.1, C10.1, C32.1, U3.8 (VDD/VREF), U4.1 (VCC), U5.1 (H1XV), U5.4 (H1YV), U9.1 (VCC)
