niftypsycho/PhobGCCv2-HW_Din/PCB/KiCAD/Stickbox_GrayStick.kicad_sch

## KiCad design PCB/KiCAD/Stickbox_GrayStick.kicad_sch (2023-04-25)

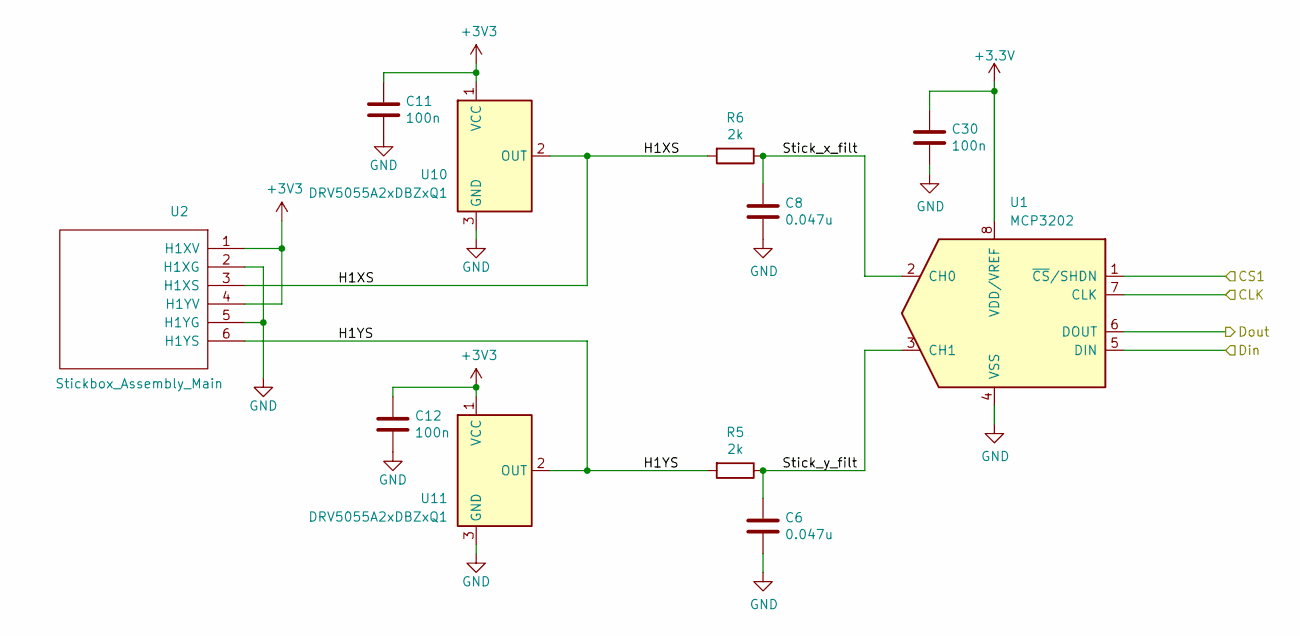
[picture p25: schematic Stickbox_GrayStick.kicad_sch]

Parts:
C6, C8: 0.047u; C_0603_HandSoldering; MPN CL10B473KB8NNNC; LCSC C1622
C11, C12: 100n; C_0603_1608Metric; MPN CL10B104KB8NNWC
C30: 100n; C_0402_1005Metric; MPN CL05B104KA5NNNC
R5, R6: 2k; R_0603_1608Metric_Pad0.98x0.95mm_HandSolder; MPN RC0603FR-132KL; LCSC C22975
U1: MCP3202; SOIC-8_3.9x4.9mm_P1.27mm; MPN MCP3202-CI/SN
U2: Stickbox_Assembly_Main; GCC_Stickbox_Hall_Only; MPN T3+Magnet_Assy
U10, U11: DRV5055A2xDBZxQ1; SOT-23; MPN DRV5055A3QDBZR; LCSC C266128

Connections:
+3.3V: C30.1, U1.8 (VDD/VREF)
+3V3: C11.1, C12.1, U2.1 (H1XV), U2.4 (H1YV), U10.1 (VCC), U11.1 (VCC)
CLK: U1.7 (CLK)
CS1: U1.1 (~CS/SHDN)
Din: U1.5 (DIN)
Dout: U1.6 (DOUT)
GND: C6.2, C8.2, C11.2, C12.2, C30.2, U1.4 (VSS), U2.2 (H1XG), U2.5 (H1YG), U10.3 (GND), U11.3 (GND)
H1XS: R6.2, U2.3 (H1XS), U10.2 (OUT)
H1YS: R5.2, U2.6 (H1YS), U11.2 (OUT)
Stick_x_filt: C8.1, R6.1, U1.2 (CH0)
Stick_y_filt: C6.1, R5.1, U1.3 (CH1)
