niftypsycho/PhobGCCv2-HW_Din/PCB/KiCAD/TriggerPaddles.kicad_sch

## KiCad design PCB/KiCAD/TriggerPaddles.kicad_sch (2023-04-25)

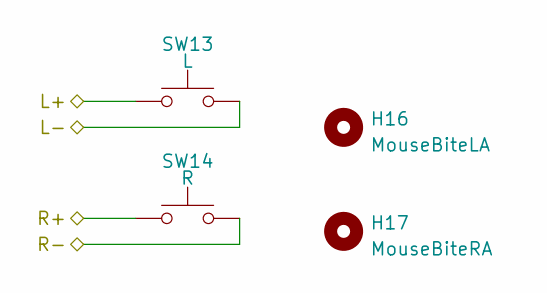
[picture p26: schematic TriggerPaddles.kicad_sch]

Parts:
H16: MouseBiteLA; breakaway-mousebites-double
H17: MouseBiteRA; breakaway-mousebites-double
SW13: L; Trigger_Contact_Big
SW14: R; Trigger_Contact_Big

Connections:
L+: SW13.1
L-: SW13.2
R+: SW14.1
R-: SW14.2
