niftypsycho/PhobGCCv2-HW_Din/PCB/KiCAD/TriggerSliders.kicad_sch

## KiCad design PCB/KiCAD/TriggerSliders.kicad_sch (2023-04-25)

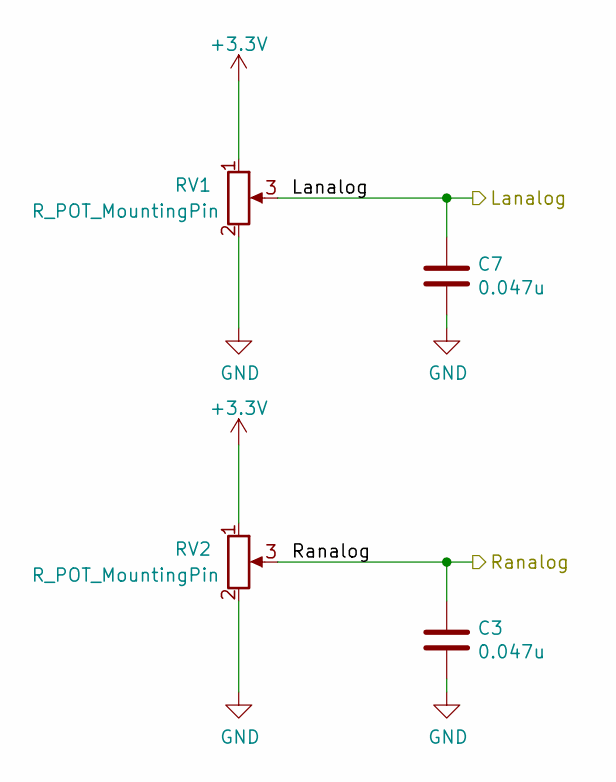
[picture p27: schematic TriggerSliders.kicad_sch]

Parts:
C3, C7: 0.047u; C_0603_HandSoldering; MPN CL10B473KB8NNNC; LCSC C1622
RV1, RV2: R_POT_MountingPin; GCC_Slider; MPN Trigger-Slider

Connections:
+3.3V: RV1.1 (V+), RV2.1 (V+)
GND: C3.2, C7.2, RV1.2 (GND), RV2.2 (GND)
Lanalog: C7.1, RV1.3 (Signal)
Ranalog: C3.1, RV2.3 (Signal)
