niftypsycho/PhobGCCv2-HW_Din/PCB/KiCAD/flash.kicad_sch

## KiCad design PCB/KiCAD/flash.kicad_sch (2023-04-25)

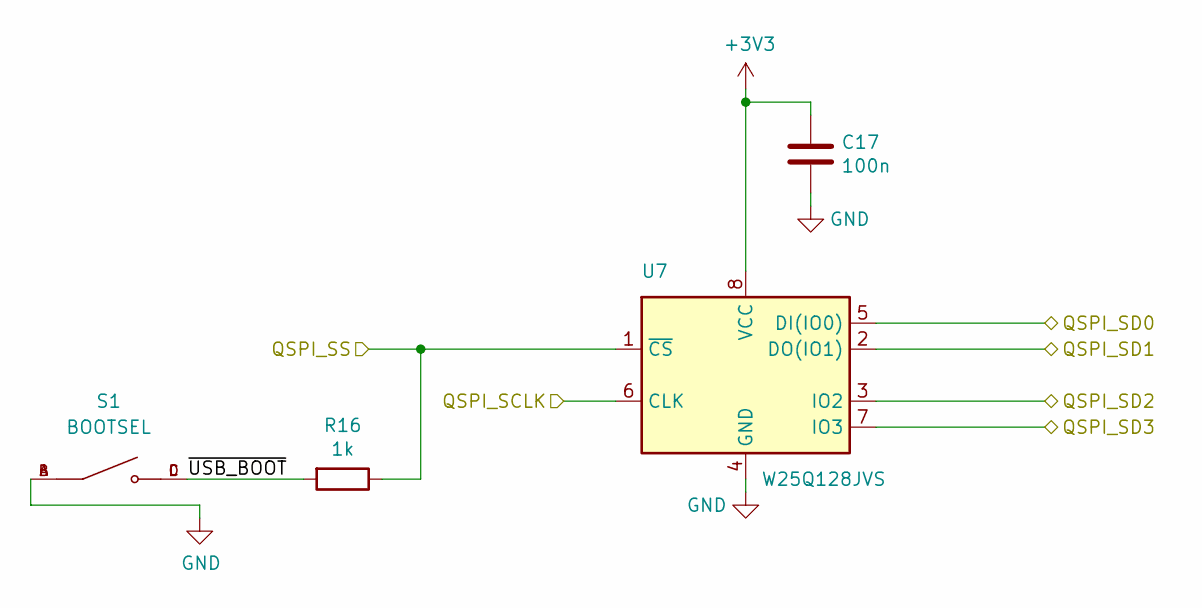
[picture p28: schematic flash.kicad_sch]

Parts:
C17: 100n; C_0402_1005Metric; MPN CL05B104KA5NNNC
R16: 1k; C_0402_1005Metric; MPN RMCF0402FT1K00
S1: BOOTSEL; SW_TS-1187A-B-A-B; PARTREV A0; LCSC C318884
U7: W25Q128JVS; SOIC-8_5.23x5.23mm_P1.27mm; MPN W25Q128JVSIQ TR

Connections:
+3V3: C17.1, U7.8 (VCC)
GND: C17.2, S1.A, S1.B, U7.4 (GND)
QSPI_SCLK: U7.6 (CLK)
QSPI_SD0: U7.5 (DI(IO0))
QSPI_SD1: U7.2 (DO(IO1))
QSPI_SD2: U7.3 (IO2)
QSPI_SD3: U7.7 (IO3)
QSPI_SS: R16.1, U7.1 (~CS)
~USB_BOOT: R16.2, S1.C, S1.D
