niftypsycho/PhobGCCv2-HW_Din/(commit log)

2023-03-24 First commit of massive redesign
    List of changes can be found in Din-Changes.txt
    [Buttons.kicad_sch, Communications.kicad_sch, Connectors.kicad_sch, Microcontroller.kicad_sch, Miscellaneous.kicad_sch, PhobGCC_2_0_0_proto_1.kicad_sch, PhobVision.kicad_sch, PowerSupply.kicad_sch]
2023-04-25 Assembly and fab upload
    Upload schematic pdf and bom csv and ibom html docs
    [Buttons.kicad_sch, Communications.kicad_sch, DH1H1_Magnet_Holder_JLCPCB.STL, MagnetHolder_underslung_DH1H1.scad, Microcontroller.kicad_sch, Miscellaneous.kicad_sch, PhobGCC_2_0_0_proto_1.csv, PhobGCC_2_0_0_proto_1.kicad_sch]
